julixiao/Metal_Detector/bluetooth_interface.pde.rtf

import processing.serial.*;

Serial myPort;
String lidCountLbl, turnCountLbl;
int i = 0;
int tY= 240;
PrintWriter currentData, pastData;
byte lastByte = 0;
OutputStream output;
int enlargementFactor = 5;

//int[] data = new int [15];

int[] data = {0, 0, 10, 260, 0, 0, 0, 0, 0, 0, 0, 0, 0, 0, 0};
/**
{ turning(1 for turning, 0 for not turning),
turnCount,
dSide,
dFront,
lidCount,
xPosLid1,
yPosLid1,
xPosLid2,
yPosLid2,
...}
**/

int timeSent, turning, turnCount, xPos, yPos, dSide, dFront, lidCount, dataIndex;
int[][] lidPos;

boolean recieved, sent, lastWasPicture;

PImage img;
PFont f;

void setup(){
size(1175, 650);

img = loadImage("160x120.jpg");

myPort = new Serial(this, "COM5", 230400); // Starts the serial communication
myPort.clear();
myPort.read();
//myPort.bufferUntil('\n'); // Defines up to which character the data from the serial port will be read. The character '\n' or 'New Line'
output = createOutput("pic.jpg");

sent = false;
recieved = false;
lastWasPicture = false;

dataIndex = 0;

f = createFont("Arial",16,true);
}

void draw(){

if(millis() - timeSent > 4000){
sent = false;
recieved = false;
}

if(millis()%500 < 20 && !sent){
if(!lastWasPicture){
println("asked for picture");
myPort.write('1');

lastWasPicture = true;
sent = true;
recieved = false;
}
else{
println("asked for data");
myPort.write('0');

lastWasPicture = false;
sent = true;
recieved = false;
}

timeSent = millis();
}

try {
while (myPort.available () > 0 && lastWasPicture) {
byte[] buffer = new byte[64];

int byteNum = myPort.readBytes(buffer);
//println("\n"+byteNum);
//byteNum = 32;

//if(byteNum > 1 && hex(buffer[0]).equals("FF") && hex(buffer[1]).equals("D8")){
//output = createOutput("pic.jpg");
//}

for(int i = 0; i < byteNum; i++){
print(hex(buffer[i]));
output.write(buffer[i]);
}

if(hex(buffer[byteNum - 1]).equals("D9") && ((byteNum > 1 && (hex(buffer[byteNum - 2]).equals("FF"))) || hex(lastByte).equals("FF"))){
output.flush();
output.close();
println("\nflushed and closed");

img = loadImage("pic.jpg");
output = createOutput("pic.jpg");

sent = false;
recieved = true;
}
else{
lastByte = buffer[byteNum - 1];
}
}
}
catch (IOException e) {
e.printStackTrace();
}

while(myPort.available () > 0 && !lastWasPicture){
data[dataIndex] = int(myPort.read());
println(data[dataIndex]);
dataIndex++;

if(dataIndex == 15){
dataIndex = 0;
sent = false;
recieved = true;
}
}

turning = data[0];
turnCount = data[1];
dSide = data[2];
dFront = data[3];
lidCount = data[4];

lidCountLbl = "Lid Count: " + lidCount;
turnCountLbl = "Turn Count: " + turnCount;

lidPos = new int[5][2];
for(int i = 0; i < 5; i++){
lidPos[i][0] = data[5 + 2 * i];
lidPos[i][1] = data[5 + 2 * i + 1];
}

xPos = 0;
yPos = 0;

if (turnCount%2 == 0 && turnCount < 15) { //on an odd column
xPos = dSide + 10 + 10;// + 10 to centre the image of the cart
yPos = 300 - dFront - 20;// - 200 to centre the image of the cart
} else if (turnCount%2 != 0 && turnCount < 15) {// on an even column
xPos = 300 - dSide - 10;
yPos = dFront + 20;
} else if (turnCount == 0|| turnCount == 15 || turnCount == 19) {//last left 90 turn or the car has stopped
xPos = dFront + 20;
yPos = dSide + 10 + 10;
} else if (turnCount == 16 || turnCount == 18) {
xPos = dSide + 10 + 10;
yPos = 300 - dFront - 20;
} else if (turnCount == 17) {
xPos = 300 - dFront - 20;
yPos = 300 - dSide - 10;
}

clear();
background(225);

stroke(150);
image(img, 25, 25, 160 * enlargementFactor, 120 * enlargementFactor);

fill(255);
rect(25 + 160 * enlargementFactor + 20, 25, 300, 300);

noStroke();

fill(255, 0, 0);
ellipse( 25 + 160 * enlargementFactor + 20 + xPos, 25 + yPos, 25, 25);

fill(150);
for (int i = 0; i < lidCount; i++) {
ellipse( 25 + 160 * enlargementFactor + 20 + lidPos[i][0], 25 + lidPos[i][1], 15, 15);
}

textFont(f,16); // STEP 3 Specify font to be used
fill(0); // STEP 4 Specify font color
text(lidCountLbl, 25 + 160 * enlargementFactor + 20 + 10, 25 + 300 + 35);
text(turnCountLbl, 25 + 160 * enlargementFactor + 20 + 10, 25 + 300 + 25 + 35);

noFill();
}
