julixiao/Metal_Detector/Schematic.pdf

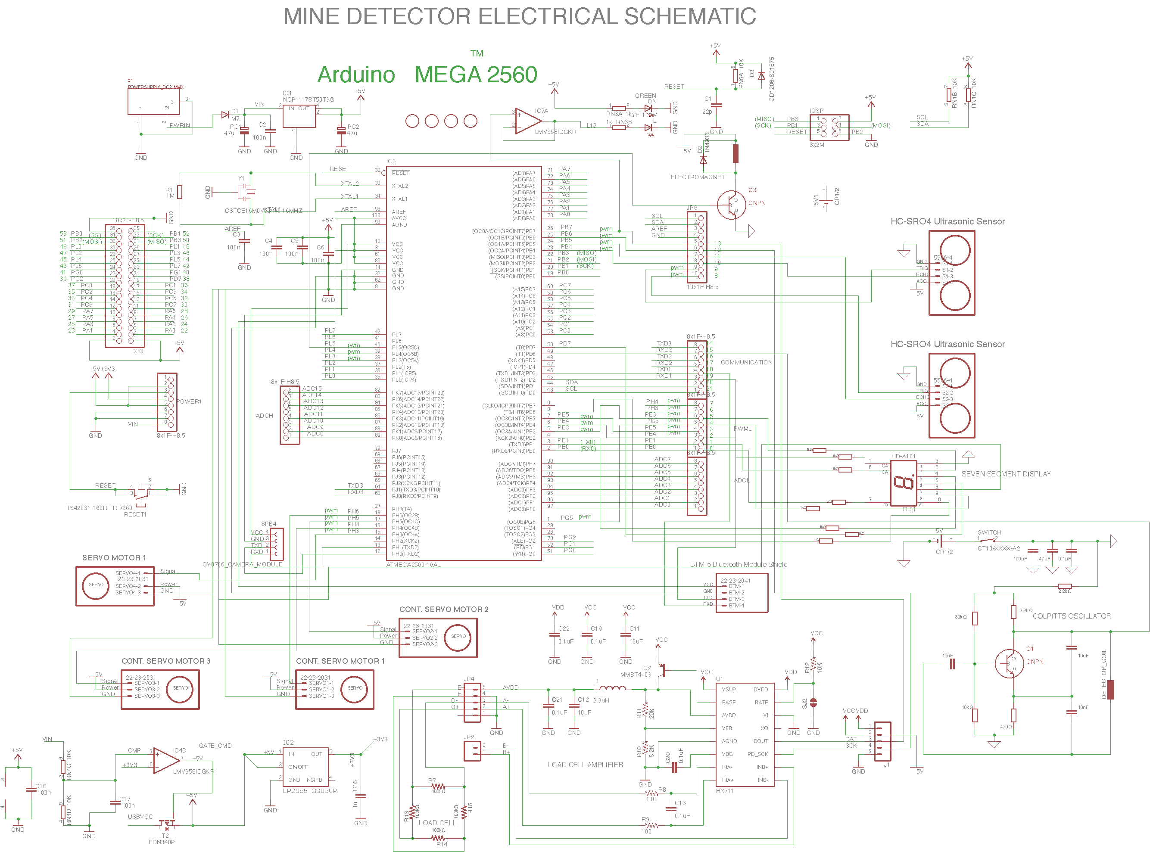
[picture p1: page 1]

Full view of Mine Detector Schematic

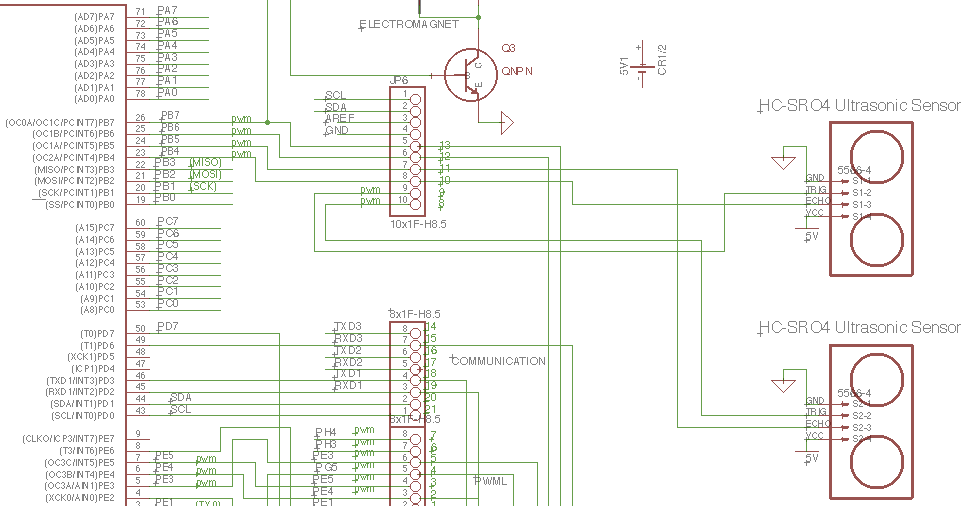
[picture p2: page 2]

HC-SRO4 Ultrasonic Sensor connection with Arduino Mega 2560

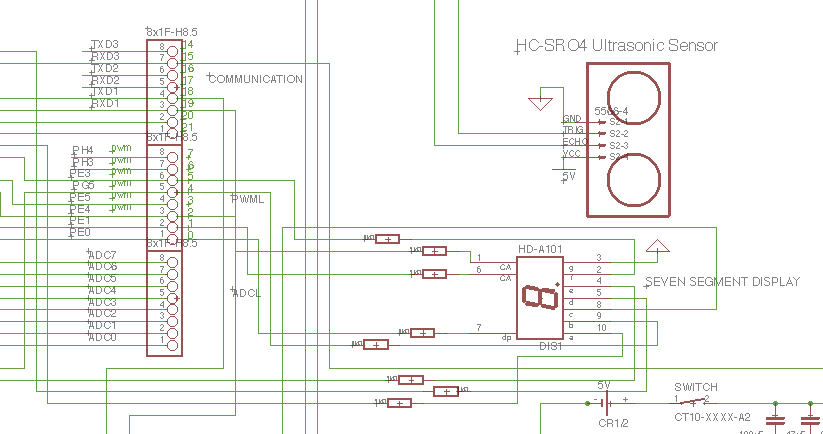
[picture p3: page 3]

Seven Segment Display connection with Arduino Mega 2560

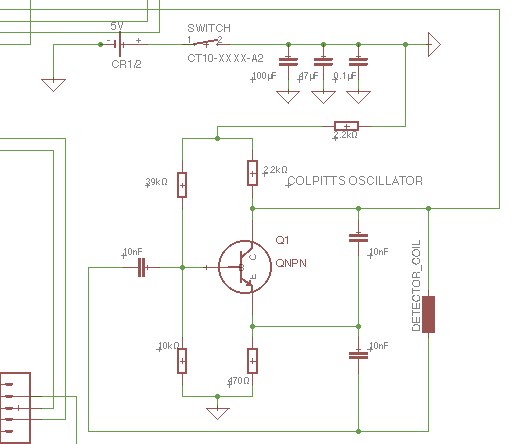
[picture p4: page 4]

Colpitts Oscillator (Mine detection) Circuit Diagram

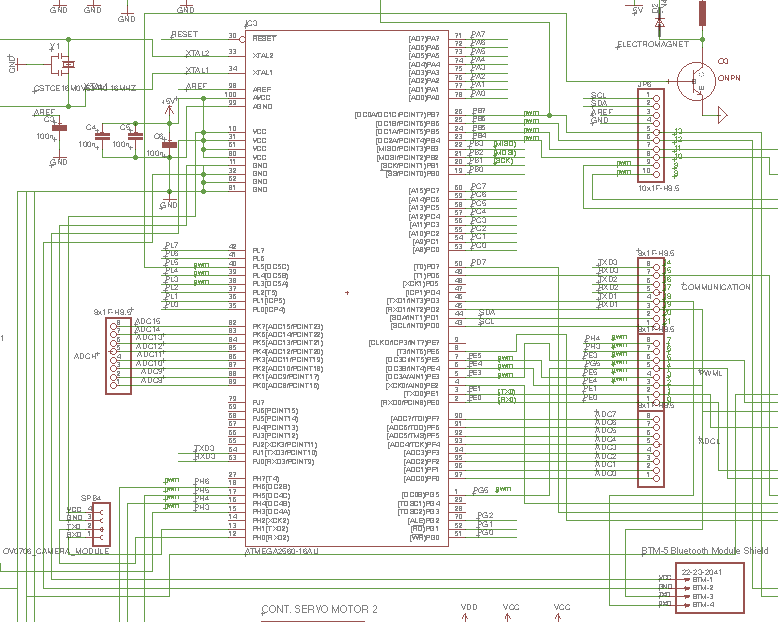
[picture p5: page 5]

Bluetooth Module connection to Arduino Mega 2560

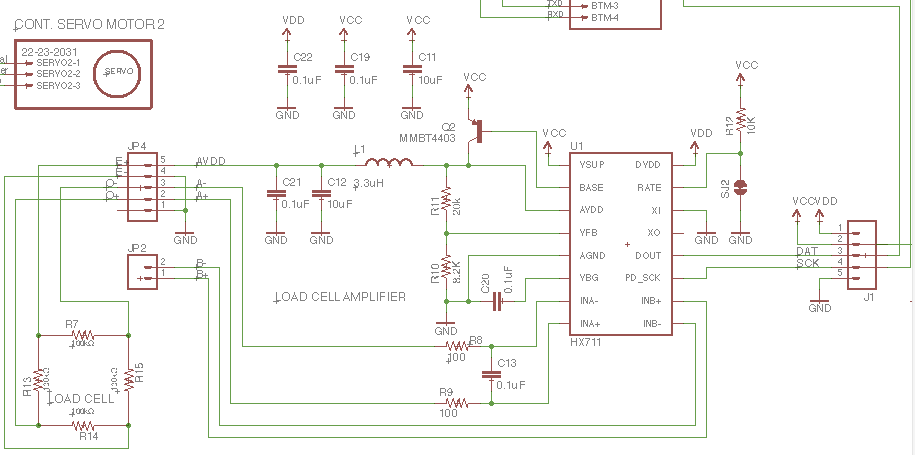
[picture p6: page 6]

Load Cell and Load Cell Amplifier connection, and Load Cell Amplifier connection to Arduino Mega 2560

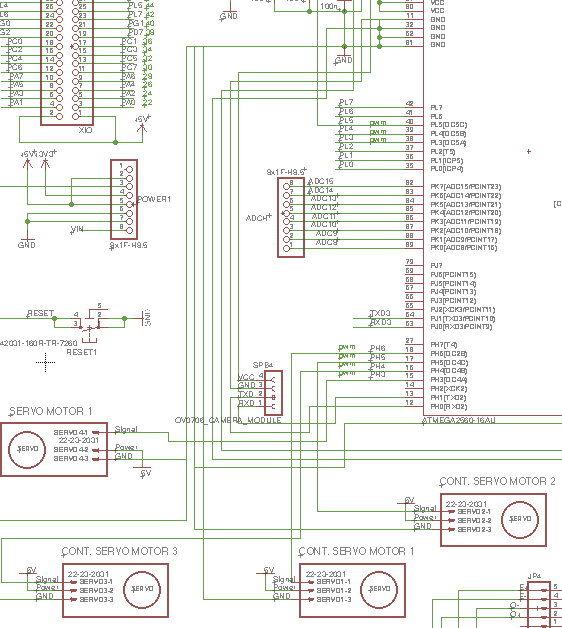
[picture p7: figure]

Three Continuous Servo Motors and Servo Motor connection to Arduino Mega 2560

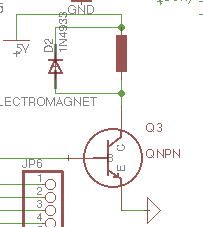
[picture p8: figure]

Electromagnet connection with Arduino Mega 2560 (connects with Digital IO pin)

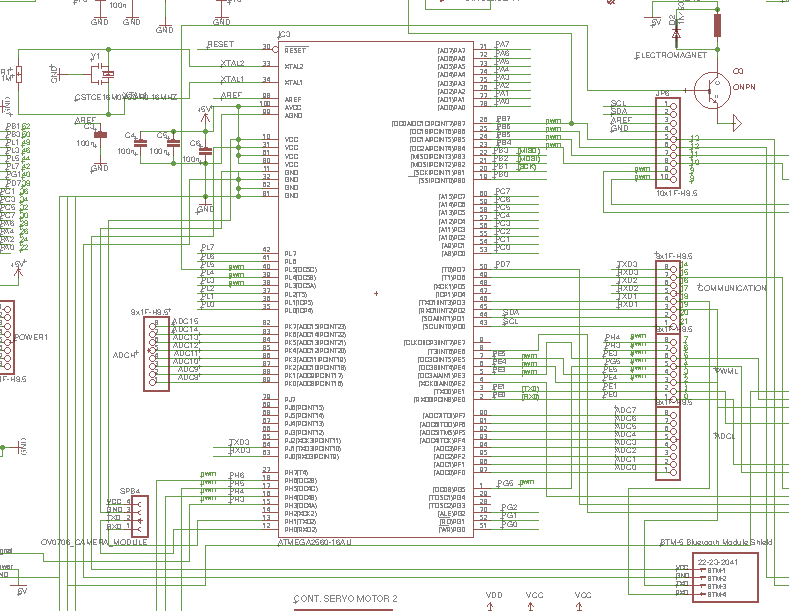
[picture p9: page 9]

Close-up of Arduino Mega 2560 pin connections

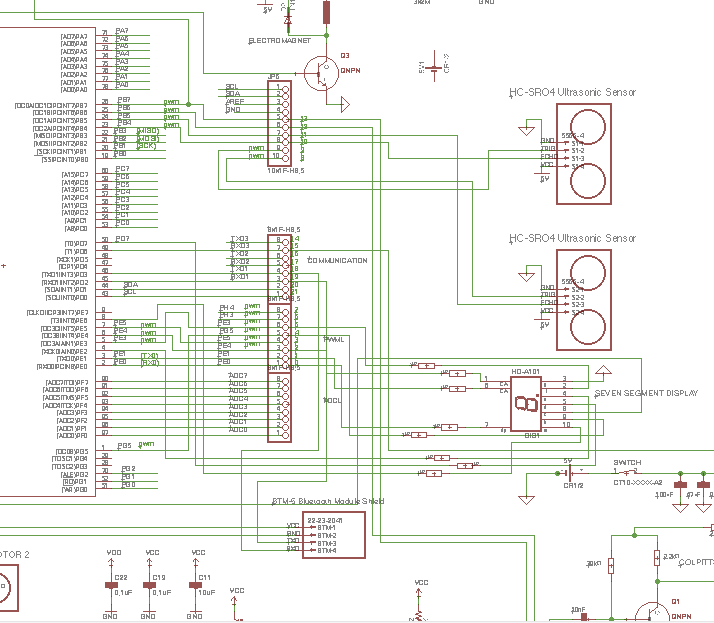
[picture p10: page 10]

Right Side Close-up of Mine Detector Schematic

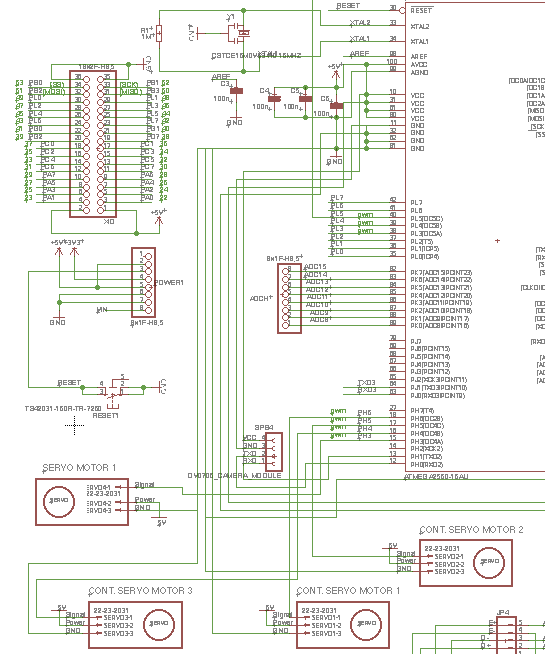
[picture p11: figure]

Left Side Close-Up of Mine Detector Schematic
