julixiao/Metal_Detector/Diagrams.pdf

## AutoCad Drawings

## Back Cover

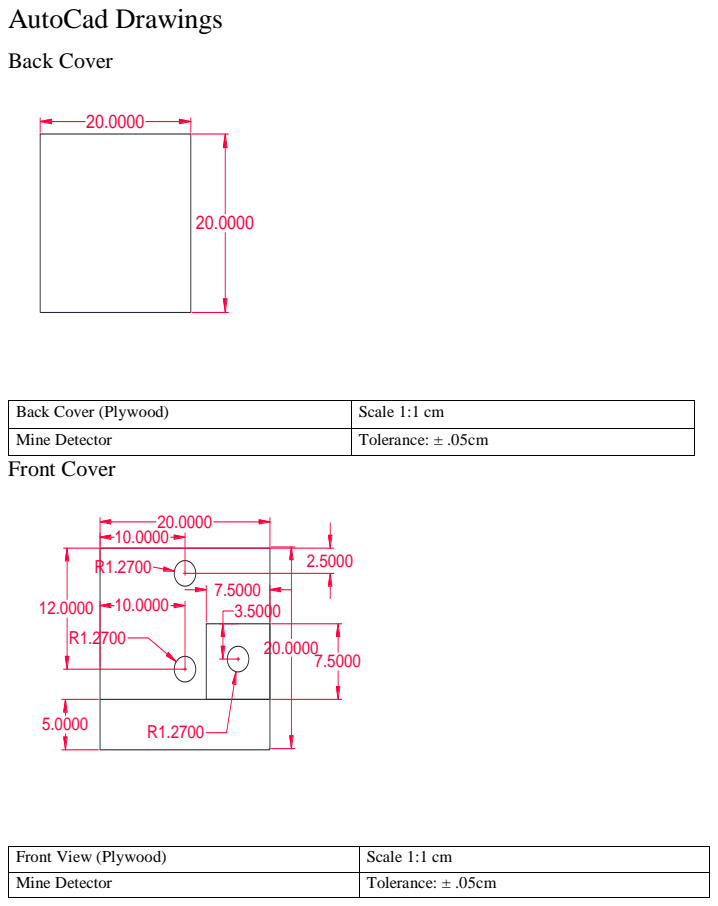
[picture p22: page 1]
Front Cover

Back Cover (Plywood) | Scale 1:1 cm
Mine Detector | Tolerance: ± .05cm

Front View (Plywood) | Scale 1:1 cm

## Side Panels

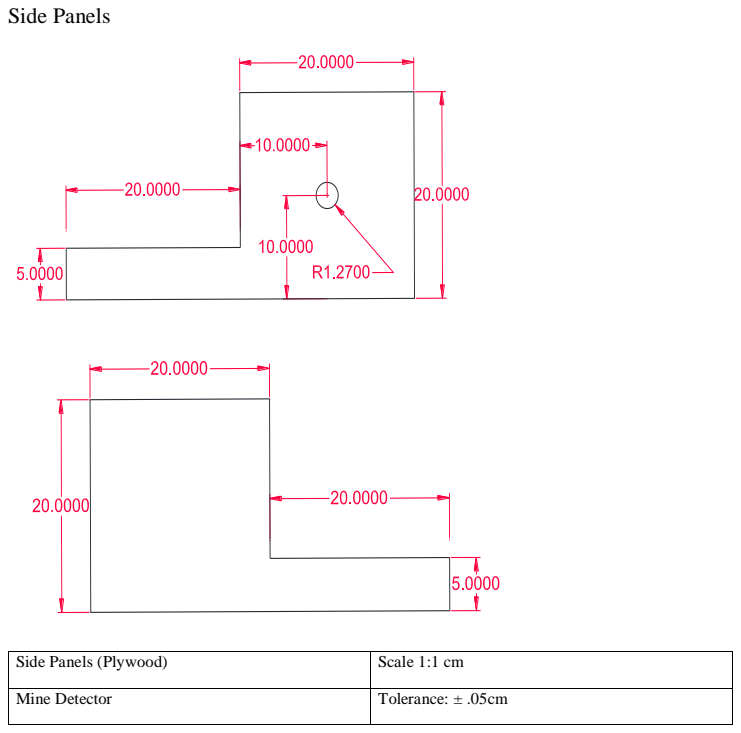
[picture p23: page 2]

Side Panels (Plywood) | Scale 1:1 cm

Mine Detector | Tolerance: ± .05cm

## Top View

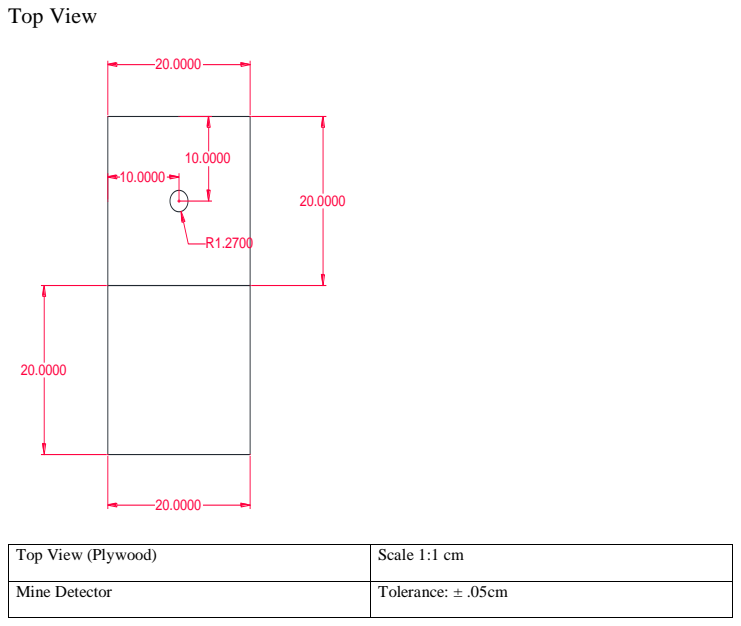
[picture p24: page 3]

Top View (Plywood) | Scale 1:1 cm

Mine Detector | Tolerance: ± .05cm

## Underside

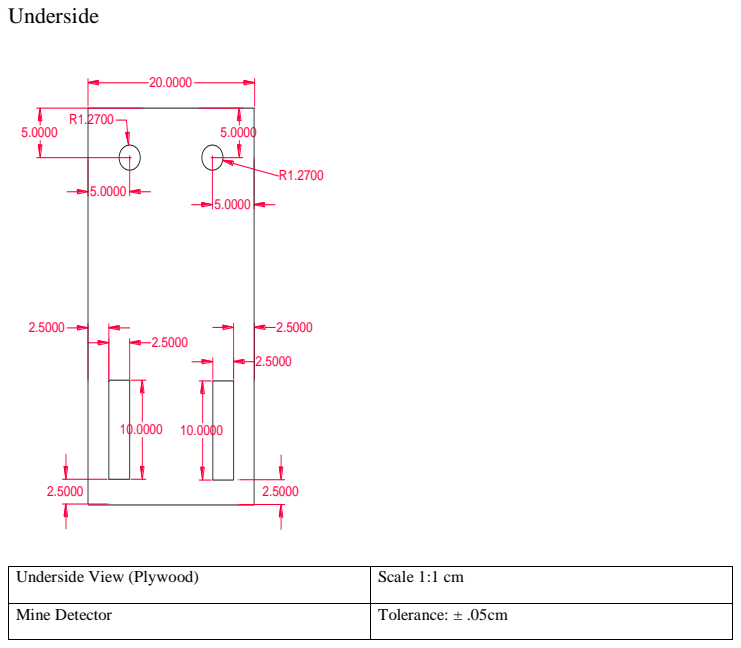
[picture p25: page 4]

Underside View (Plywood) | Scale 1:1 cm

Mine Detector | Tolerance: ± .05cm

## Metal Detector

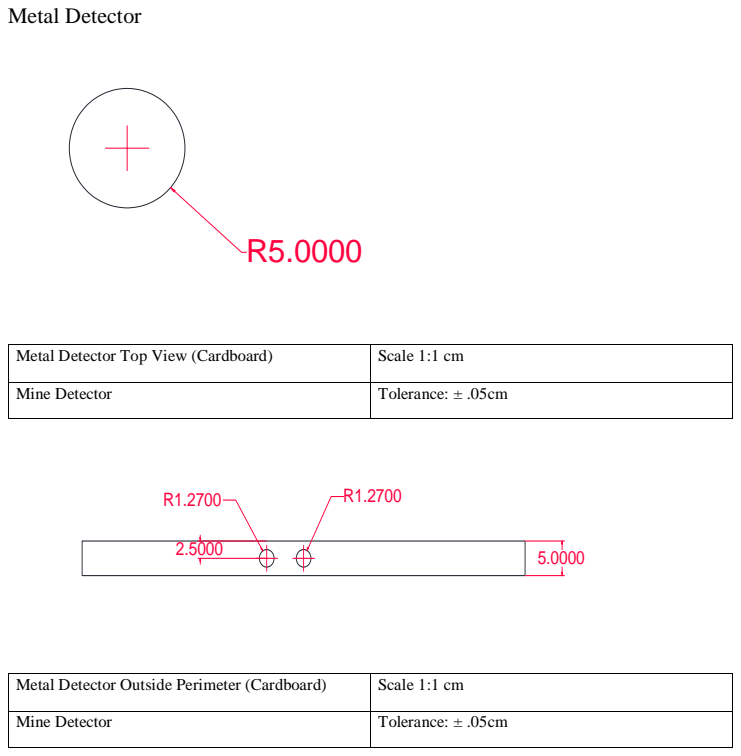
[picture p26: page 5]

Metal Detector Top View (Cardboard) | Scale 1:1 cm

Mine Detector | Tolerance: ± .05cm

Metal Detector Outside Perimeter (Cardboard) | Scale 1:1 cm

## Electromagnet

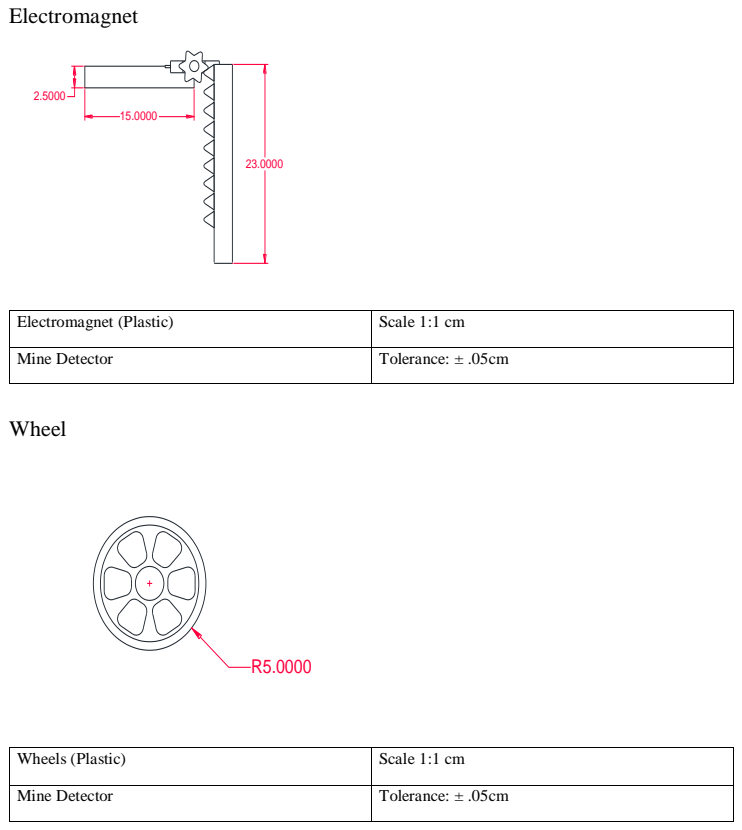
[picture p27: page 6]
Wheel

Electromagnet (Plastic) | Scale 1:1 cm

Mine Detector | Tolerance: ± .05cm

Wheels (Plastic) | Scale 1:1 cm

## Final Design

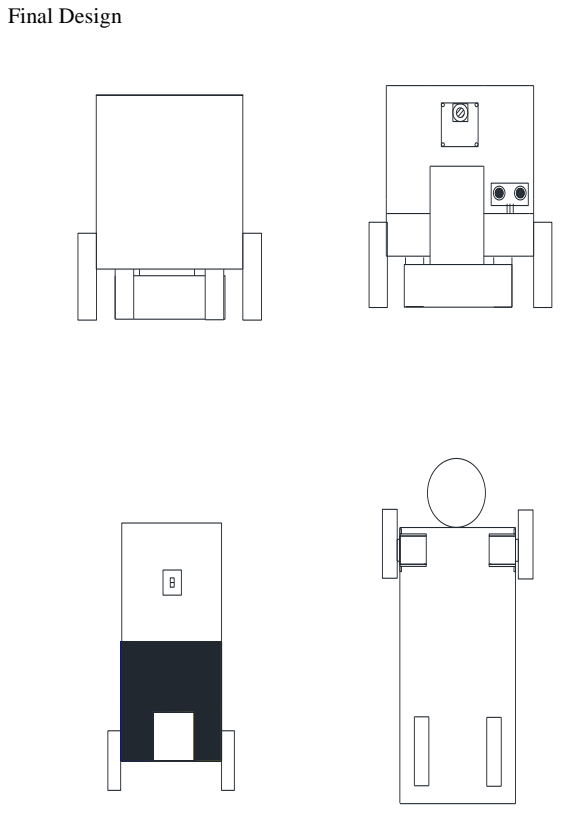
[picture p28: page 7]

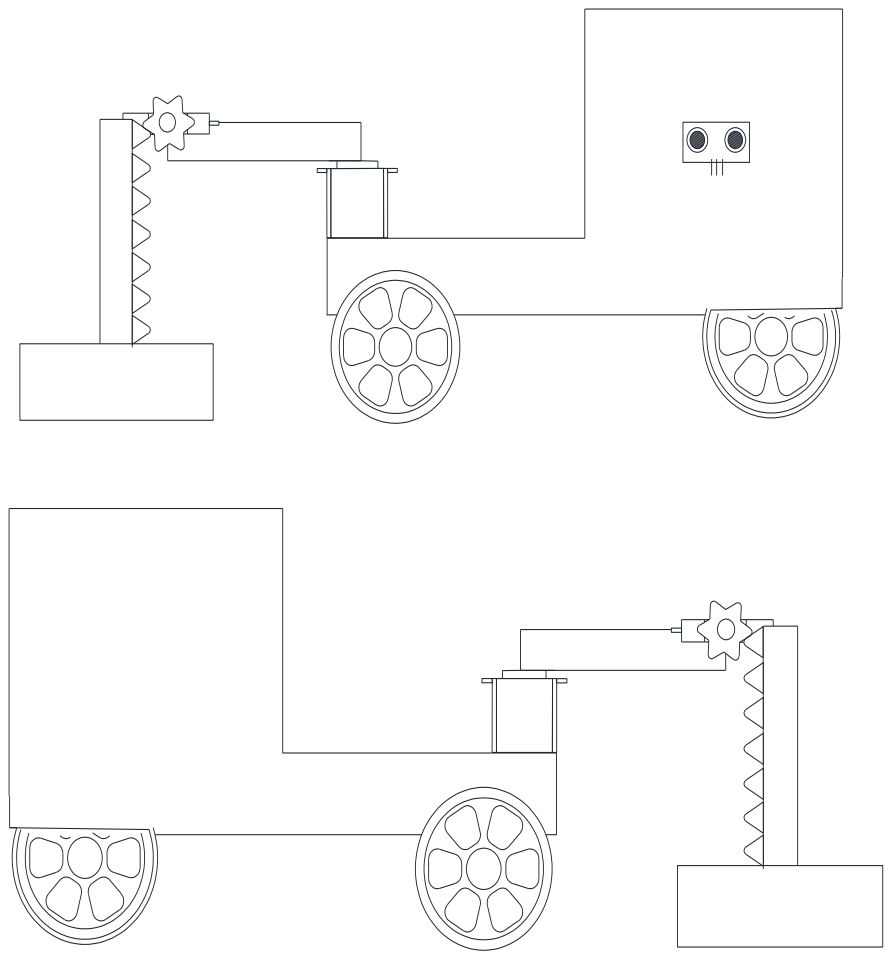
[picture p29: page 8]
